bhatchandan99/lizard_inspired_bot/README.md

# Lizard_inspired_bot
#### [Final_Report](Lizard_inspired_bot/Report.pdf)

### A legged-lizard-inspired robot was designed with a degree of freedom 3.This can move on a flat surface, the bot was tested on different types of flat surfaces.
### This project is arduino based and for simulation VREP wased used for which the script was written in python.

### This project was jointly done by
#### Bansal Kumar
#### Chandan Bhat
#### Prateek Gupta
#### Aman Deep
