bhatchandan99/lizard_inspired_bot/Lizard_inspired_bot/Report.pdf

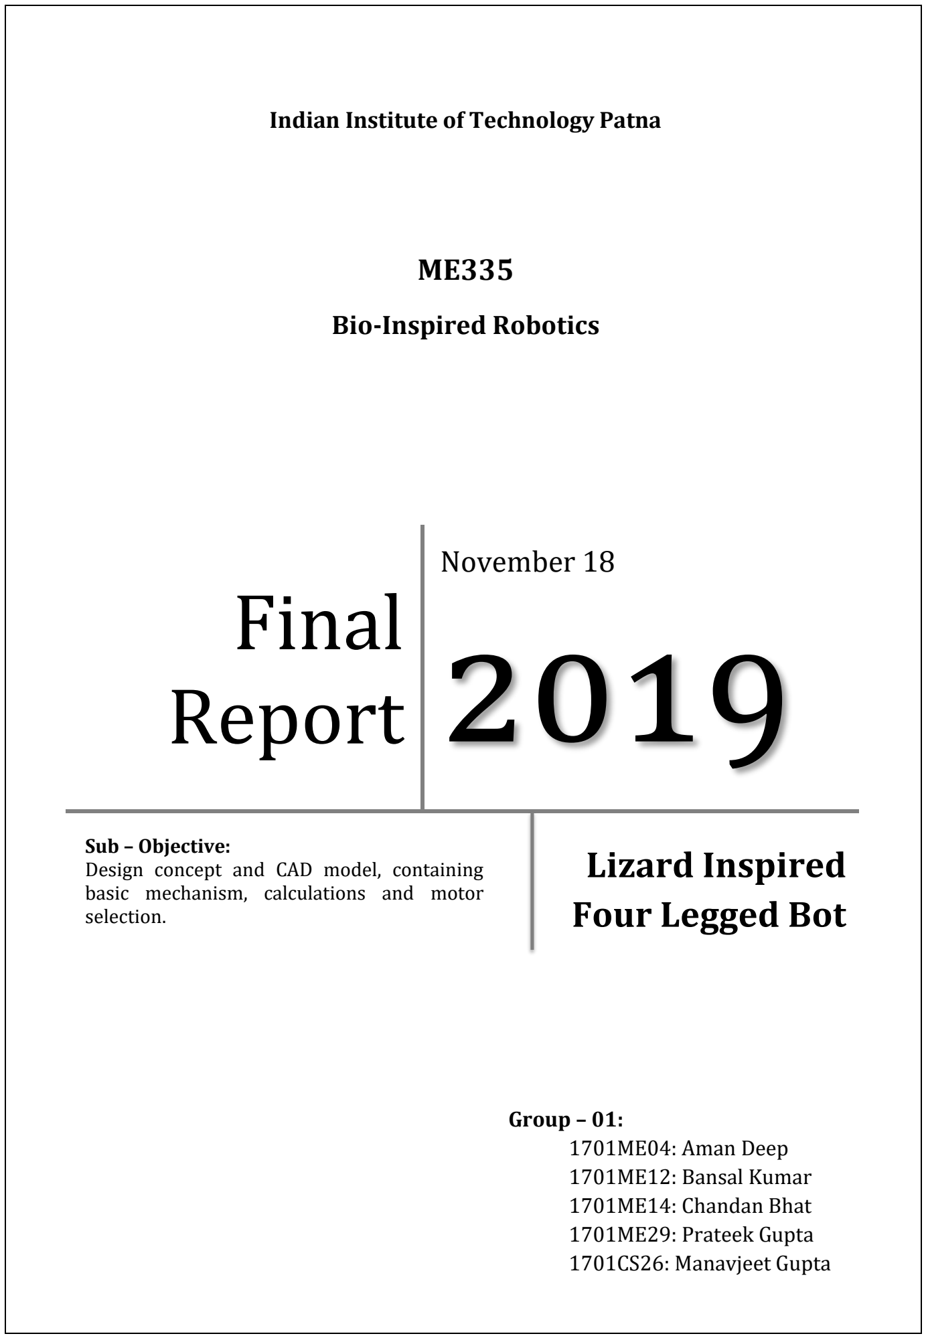
[picture p1: figure]
Final Report; November 18 2019; Indian Institute of Technology Patna; Group – 01: 1701ME04: Aman Deep 1701ME12: Bansal Kumar 1701ME14: Chandan Bhat 1701ME29: Prateek Gupta 1701CS26: Manavjeet Gupta; Lizard Inspired Four Legged Bot; Bio-Inspired Robotics; Sub – Objective:; basic mechanism, calculations and motor selection.

Design concept and CAD model, containing

Project Objective

To design a four-legged lizard-inspired robot (no wheels) with following functions and properties:

- It can travel on a straight line 25 times its body’s largest dimension in two minutes or less.
- Maximum body length should be less than 30 cm.
- Off-the-shelf motors must be used.
- The batteries and the controllers must be embedded in the robot structure and robot operation should be untethered.
- FDM is to be used for making structures.
- Programming of robot locomotion is required.
Introduction

Bio-Inspiration

Most lizards are quadruped and move using gaits with alternating movement of the right and left limbs with substantial body bending. The muscles of its body help it in achieving a perfectly synchronized motion. The centre of gravity of the lizard is very low giving it good static as well as dynamic stability.

Legged Robots

Legged robots are a type of mobile robot, (https://en.wikipedia.org/wiki/Mobile_robot) which use articulated limbs, such as leg mechanisms, (https://en.wikipedia.org/wiki/Leg_mechanism) to provide locomotion. (https://en.wikipedia.org/wiki/Robot_locomotion) They are more versatile than wheeled robots and can traverse many different terrains, though these advantages require increased complexity and power consumption.

Design Concept

CAD Model

Description

The body is mainly divided in two parts, each having a set of legs. Each set moves corresponding to one motor only. The two parts are joined together in middle which includes a third motor which rotates the two parts lifting one side of the body in both the parts. It also includes space for battery, Arduino Nano, mini breadboard and wires.

Walking Mechanism

- 4 Leg-Gait Walking Mechanism.
- Front legs point forward while rear leg points backward.
- 1 motor actuates front legs and the other rear ones.
- A third motor is used to twist the body from middle

Leg Configurations

Four legs are constructed to provide ample ground clearance. There is an extension from the body away which bends downward. This bend is chosen as to be front bend in front legs and reverse bend in rear legs. This configuration is direct concept from lizard’s own body. This configuration is also required based on above pictures.

Also hemispherical end to the leg is given at contact points to have desired normal reactions and grip is attached to get sufficient coefficient of friction.

## Electronics

- Battery Li-Po 7.4 V
- IC 7805 (for voltage regulation)
- Arduino-Nano
- Bluetooth Module (HC05)
- Mini Bread-Board
- Servo-Motor 10.6 kg-cm torque

Calculation of Torque for Servo-Motor

Length of One End of Leg from Mid-Plane = 70 mm

Weight = 0.6 kg and Factor of Safety = 2

## Bot Characteristics

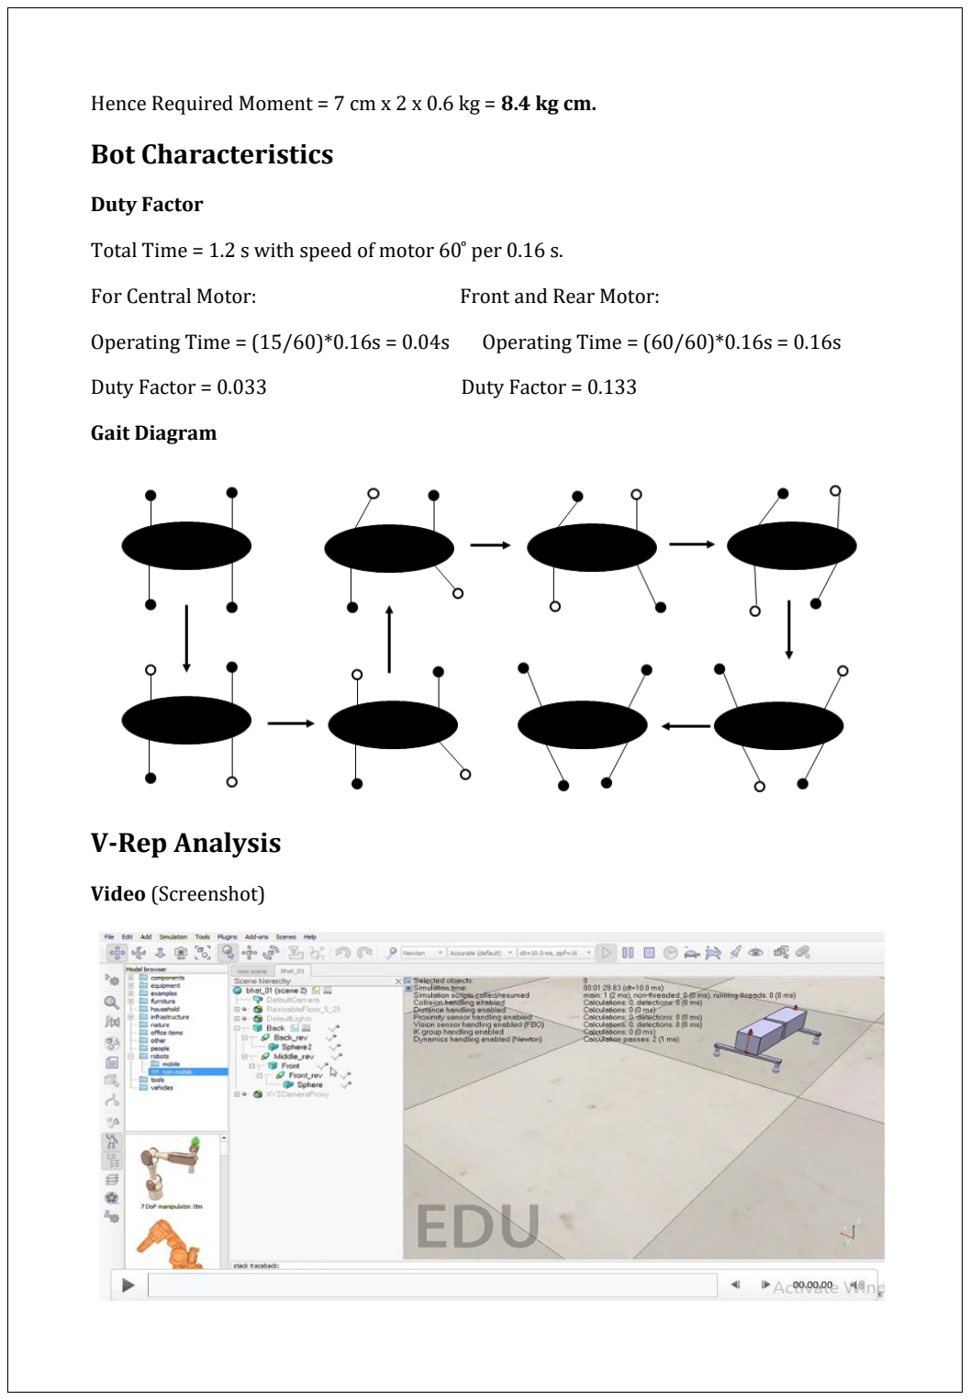
[picture p2: page 4]

Hence Required Moment = 7 cm x 2 x 0.6 kg = 8.4 kg cm.

Duty Factor

Total Time = 1.2 s with speed of motor 60 ͦper 0.16 s.

For Central Motor: | Front and Rear Motor:
Operating Time = (15/60)*0.16s = 0.04s | Operating Time = (60/60)*0.16s = 0.16s
Duty Factor = 0.033 | Duty Factor = 0.133

Gait Diagram

## V-Rep Analysis

Video (Screenshot)

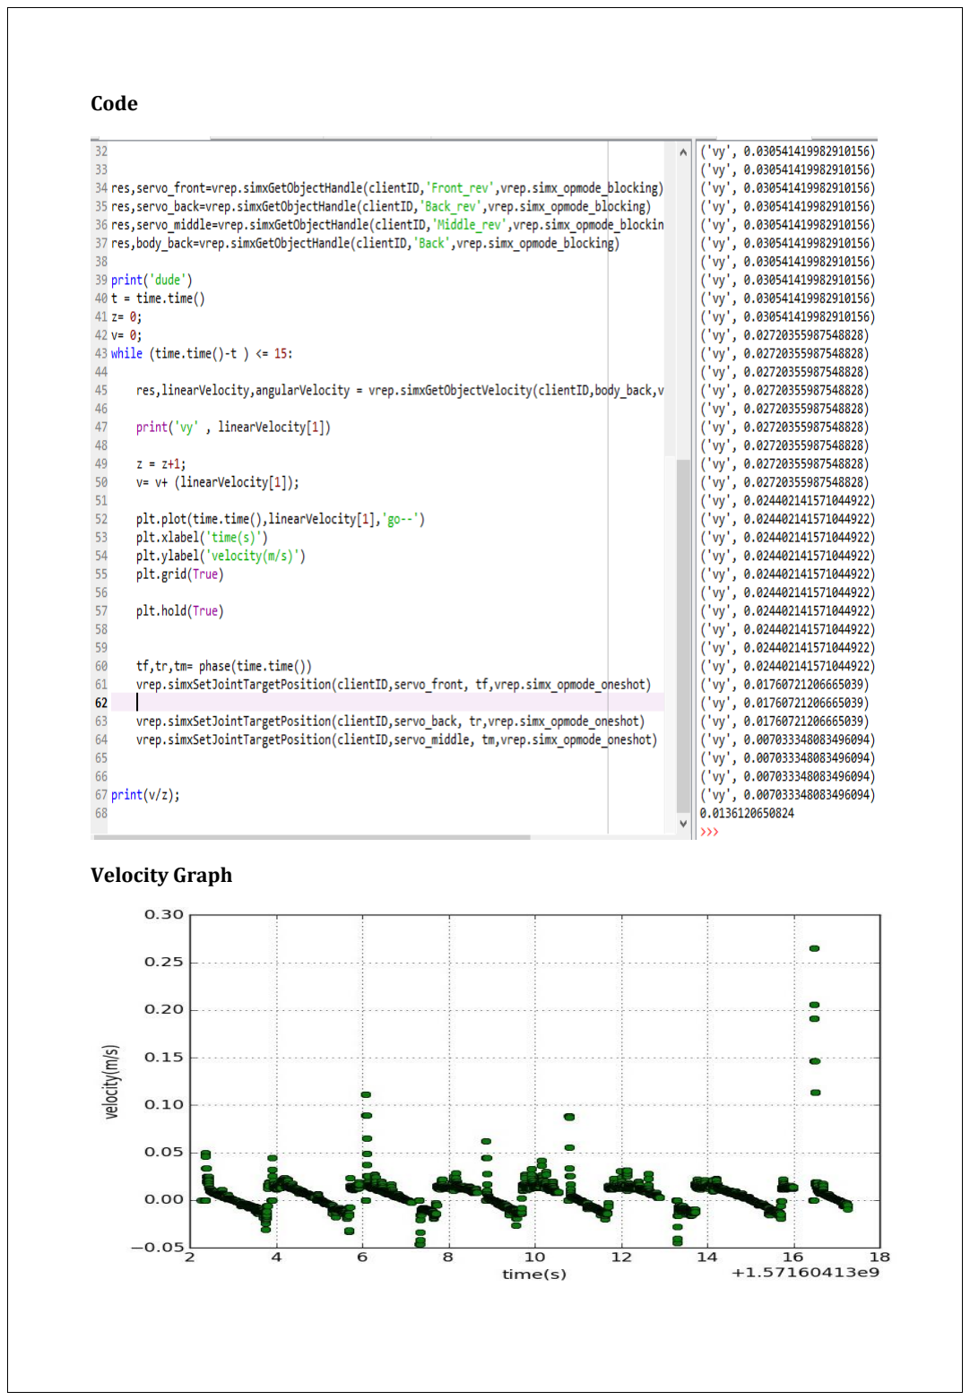
[picture p3: page 5]

Code

Velocity Graph

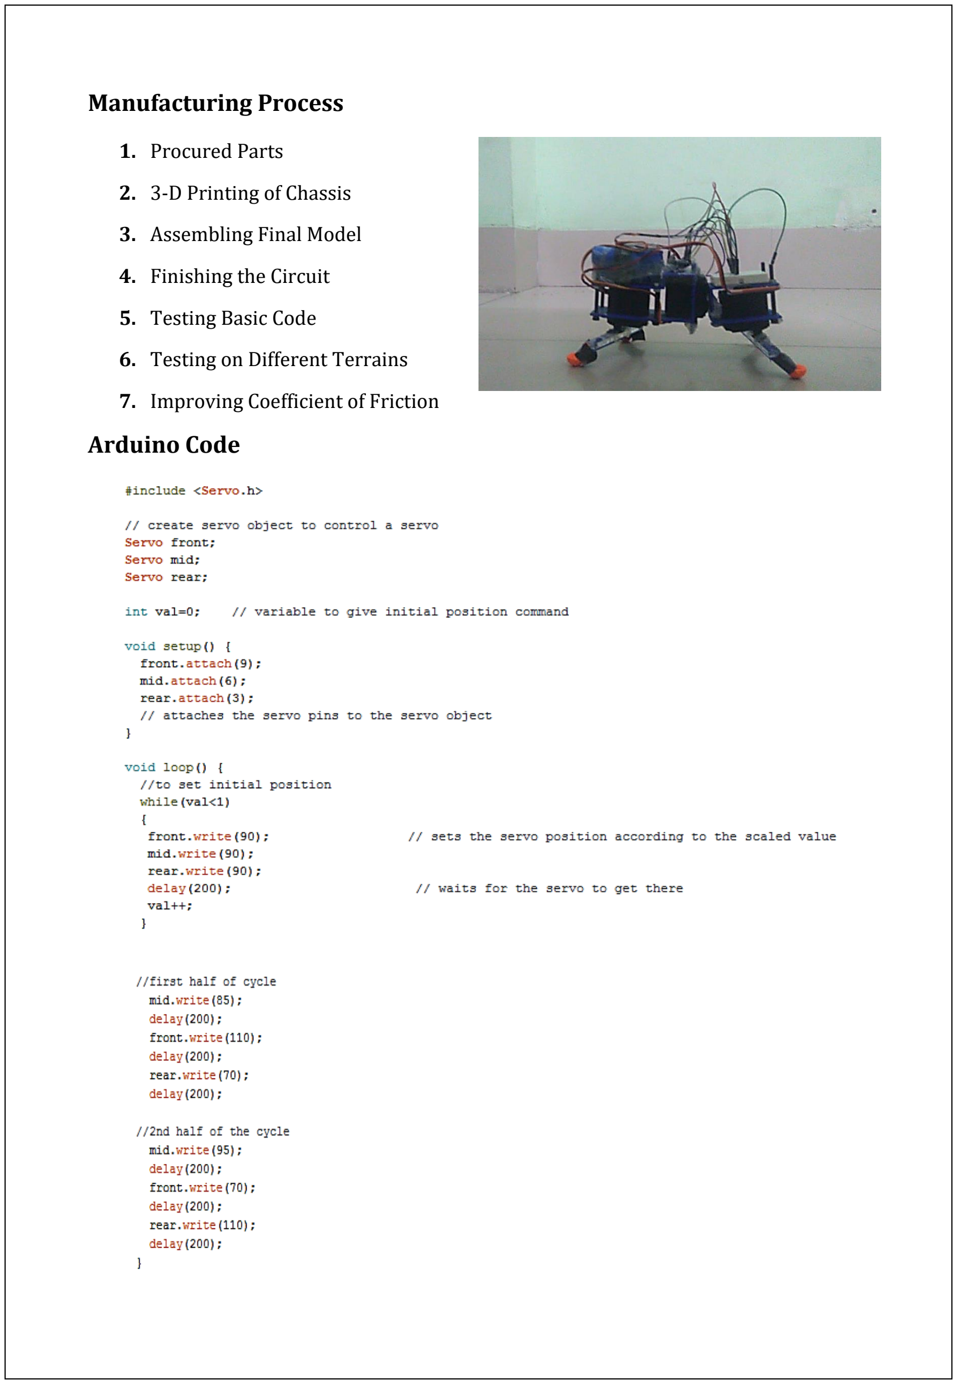
[picture p4: page 6]

Manufacturing Process

### 1. Procured Parts

2. 3-D Printing of Chassis

### 3. Assembling Final Model

### 4. Finishing the Circuit

### 5. Testing Basic Code

### 6. Testing on Different Terrains

### 7. Improving Coefficient of Friction

Arduino Code

Performance in Different Terrains

S. No. | Property | Smooth (Tile) Surface | Tennis Mat | Mud Cover
1. Screenshot

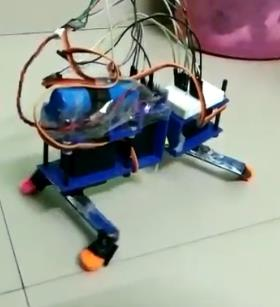
[picture p5: figure]
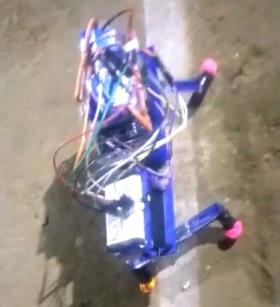
[picture p6: figure]
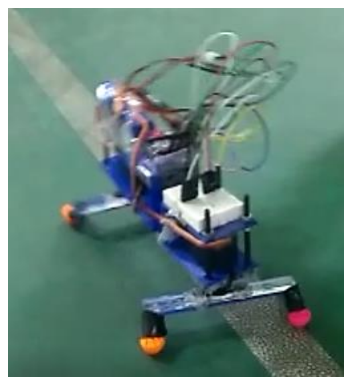
[picture p7: figure]

2. | Coefficient of Friction | Low | High | Medium
3. Distance | Travelled (in 2 min) | ~14 Body Lengths | ~22 Body Lengths | ~19 Body Lengths

“Best performance was obtained on the mat as it gave the best coefficient of friction.”

Reason for Less Travel: Because the normal reaction is less on the legs (bot weight is less), hence the legs are not able to hold their positions and slip in backward direction hence decreasing the speed.

Errors in Manufacturing

### 1. Improper Alignment of Central Motor

2. Non-Rigidity due to Bending Factor in Structure and Legs due to weight.

### 3. Unequal Reactions on Support Points

### 4. Unequal Weight Balance (taken care but not exact)

5. Joining of Servos cannot be Perfect.

### 6. Imperfection at Joints

Scope of Improvement

1. Friction at the Legs can be Improved.
2. Phase can be Better Synchronized for Faster Travel.
3. Synchronization between Amplitude and Time Period.

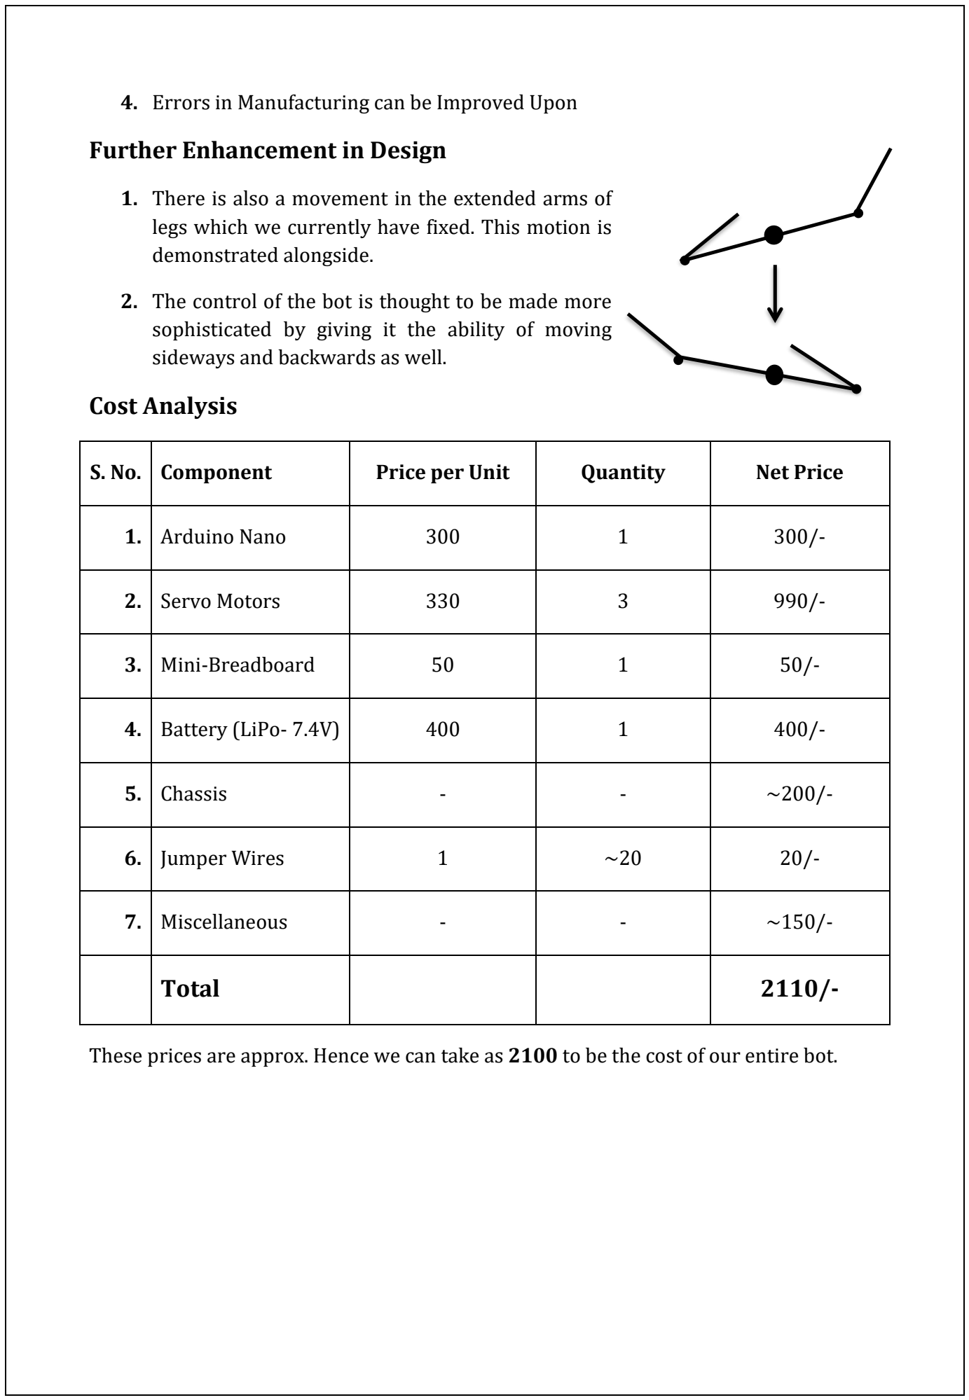
[picture p8: figure]
Further Enhancement in Design; demonstrated alongside.; sideways and backwards as well.; Cost Analysis; Arduino Nano; Servo Motors; Mini-Breadboard; Battery (LiPo- 7.4V); Chassis; Jumper Wires; Miscellaneous; Total

### 4. Errors in Manufacturing can be Improved Upon

### 1. There is also a movement in the extended arms of

legs which we currently have fixed. This motion is

### 2. The control of the bot is thought to be made more

sophisticated by giving it the ability of moving

S. No. | Component | Price per Unit | Quantity | Net Price

These prices are approx. Hence we can take as 2100 to be the cost of our entire bot.
