bhatchandan99/lizard_inspired_bot/Lizard_inspired_bot/velocity_graph.jpg

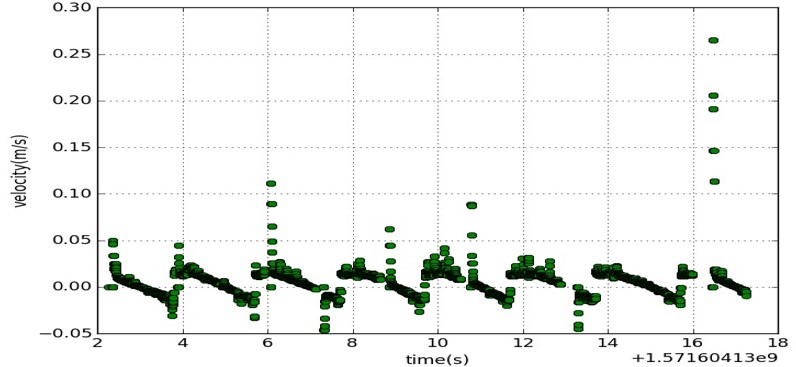
Lizard_inspired_bot/velocity_graph.jpg
